ncotti/pcbs/cotti_probe/image-1.png

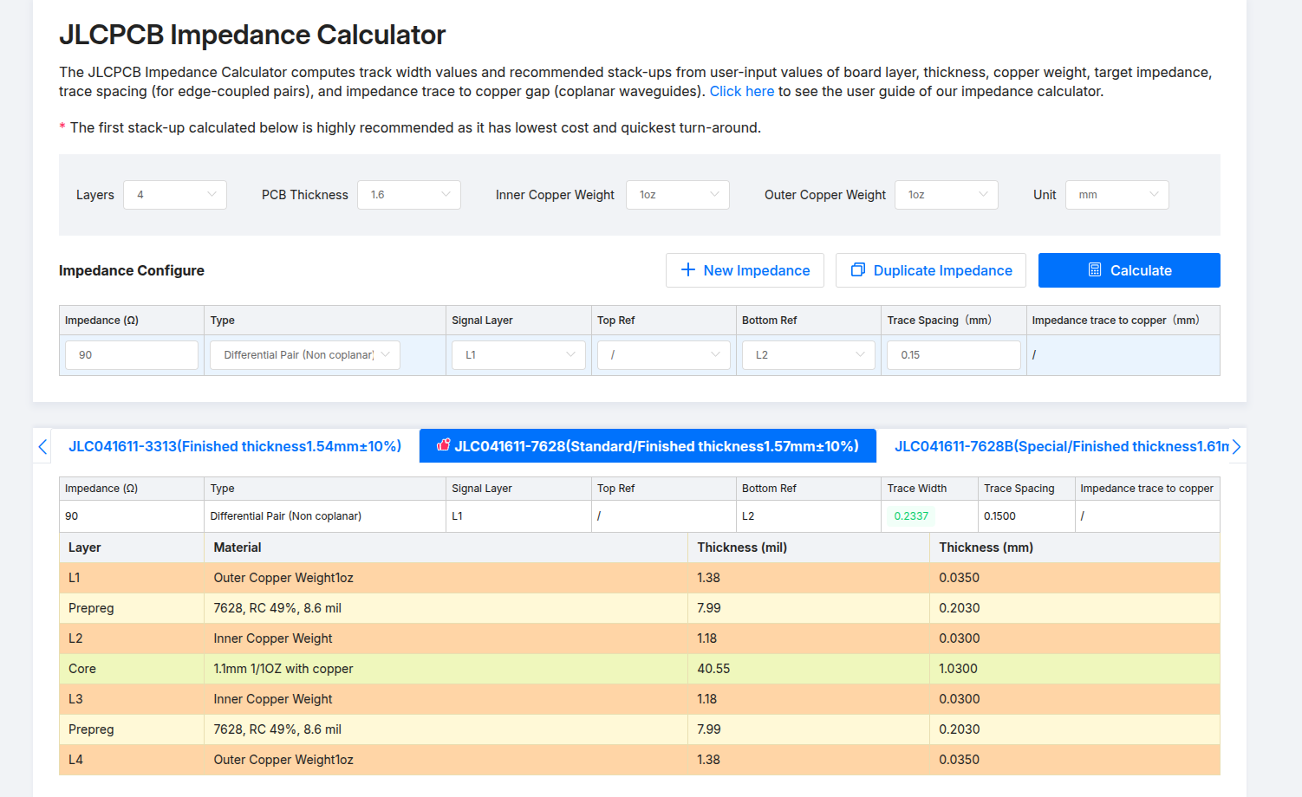
cotti_probe/image-1.png
