ncotti/pcbs/cotti_probe/image.png

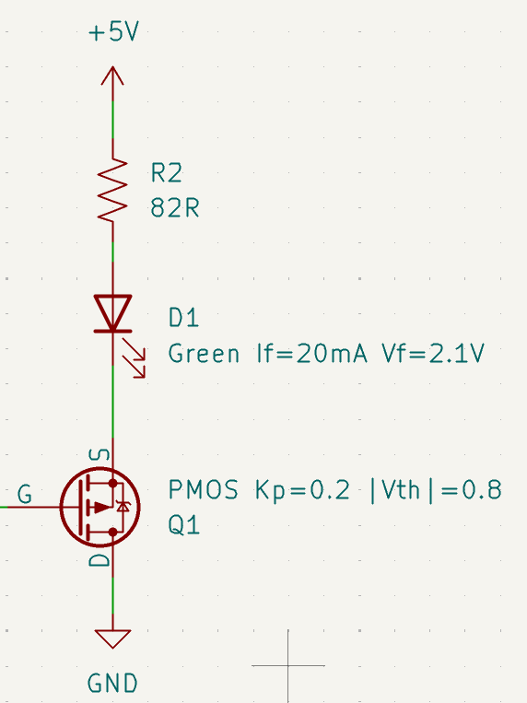
cotti_probe/image.png
