ncotti/pcbs/cotti_probe/3d_models/ABLS-12.000MHZ-20-B4Y-T.stp

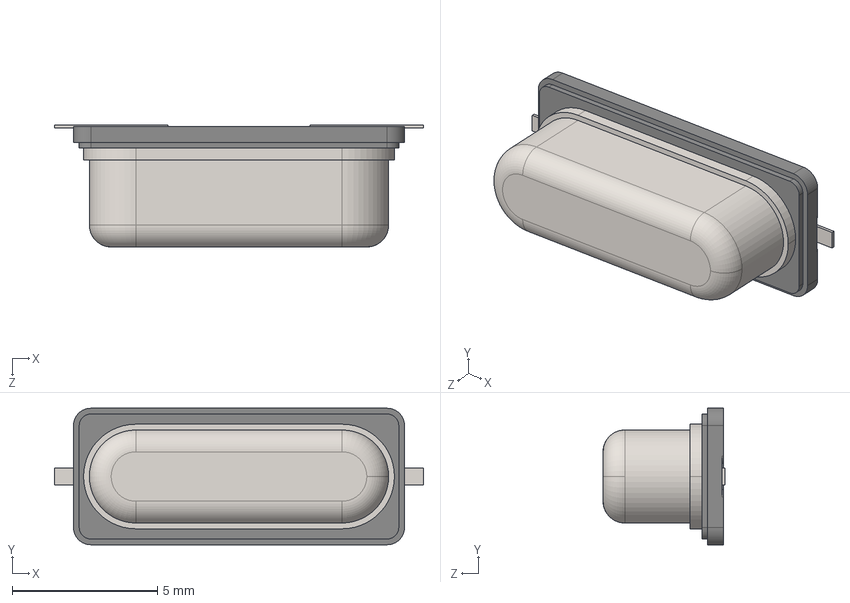
[picture p10: CAD file, 2025-12-12]
cotti_probe/3d_models/ABLS-12.000MHZ-20-B4Y-T.stp
12.7 x 4.70 x 4.20 mm
