ncotti/pcbs/microprocessors/nuvoton_nuc980/docs/reference_designs/NK-980IOT.pdf

# nRESET VDD12 VDD33 VSS

# PG5 PF[12:11]

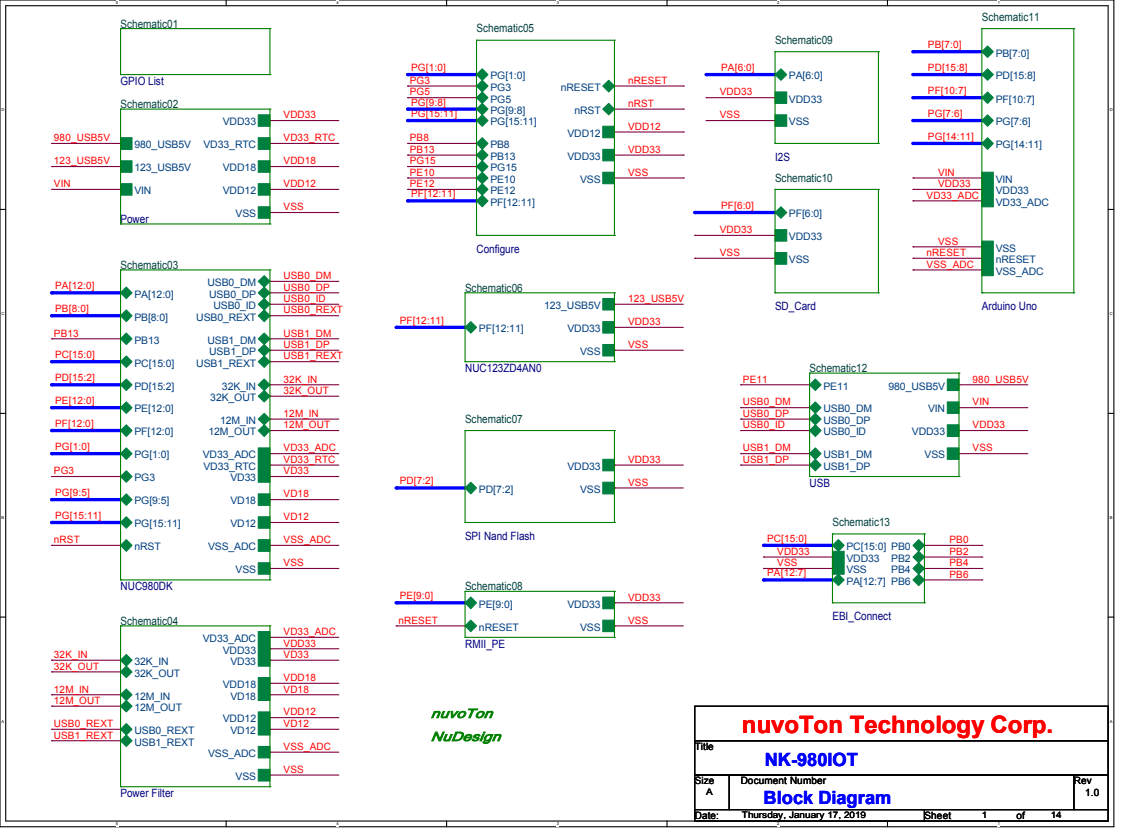
[picture p11: page 1]
A A nuvoTon; NuDesign; 123_USB5V; 980_USB5V; VDD12 VSS; VDD18 VDD33 VD33_RTC; VIN; VD12 VD18 VD33 VD33_ADC; VD33_RTC; VSS_ADC; VSS; 32K_IN 32K_OUT; 12M_IN 12M_OUT; USB0_DP; USB0_DM; USB0_REXT; USB0_ID; USB1_DP; USB1_DM; USB1_REXT; VDD12 VDD33 VSS_ADC; 32K_OUT; 12M_OUT; VDD18 VD12 VD18 VD33 VD33_ADC; VDD33 VSS; VDD33 PD[7:2]; nRESET PE[9:0]; VDD33 VSS USB0_DP; USB0_REXT USB1_REXT; nRST; VDD33 PA[6:0] VSS; VDD33 PF[6:0]; nRESET VSS; VDD33 VD33_ADC; PB0 PB2 PB4 PB6 Title Size; Document Number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

PF[10:7] nRESET VDD33 VSS

nuvoTon Technology Corp. A
NK-980IOT

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
## PIN

PA7

PA6

PA2

PA9

PA1

## FUNCTION

PA0

PA5

PA3

## I2C0_SDA

## USB0_VBUSVLD

## FUNCTION

PF4

## PIN

PF1

## JTAG0_TDO SPI1_SS0 PWM10

## JTAG0_TMS SPI1_DO PWM12 UART5_RXD

PF2

PF3

## JTAG0_NTRST LED_G

## JTAG0_TDI SPI1_DI PWM13 UART5_TXD

## JTAG0_TCK SPI1_CLK PWM11

PF0

## RMII0_TXD0

## RMII0_RXERR

PE10

PE8

PE6

## RMII0_REFCLK

## RMII0_TXD1

PE3

PE7

## RMII0_MDC

PE4

PE0

## RMII0_MDIO

## RMII0_RXD1

## FUNCTION

PE5

PE9

## RMII0_CRSDV

## RMII0_RXD0

## RMII0_TXEN

PE1

PE2

## PIN

PG1 | CFG[1]
PIN | FUNCTION

PG9

PG8

PG0

PG5

PG3

PA10

PA11

PA12

## LED_Y

## I2S_BCLK

## I2S_DI

## EBI_nRE

## EBI_nCS0

## EBI_ADDR9 (LCD_RESET) EBI_ADDR8 (LCD_BL)

PC13

PC15

PC14

PC8

PC11

PC3

PC1

## PIN

PC4

PC5

PC6

PC9

PC12

## FUNCTION

PC10

PC2

PC7

## CFG[5]

PG6

PG7

PC0

PD7

## SPI0_SS0

## SPI0_CLK

## FUNCTION

PD8

PD9

PD6

PD5

PD4

PD2

PD3

## PIN

PD10

## SPI0_DI UART6_RXD

## SPI0_DO UART6_TXD

PD11

PD12

PD13

PD14

PD15

PG11

PG12

PG13

PG14

PG15

PF5

PF6

PF7

PF8

PF9

PF10

PF11

PF12

## UART0_RXD

## UART0_TXD

PE11

PE12

## ADC_AIN[0]

PB5

PB4

## I2C2_SCL ADC_AIN[5]

PB1

PB6

## I2C2_SDA ADC_AIN[7]

PB8

## I2C1_SCL ADC_AIN[4] UART7_RXD

PB3

PB13

PB0

PB7

## PIN

PB2

## FUNCTION

## I2C1_SDA ADC_AIN[6] UART7_TXD

## I2S_DO

## EBI_ADDR10 (LCD_RS)

## I2C0_SCL

## UART4_TXD PWM00

## QSPI0_SS0

## I2S_MCLK

## EBI_nWE

## Key1

## Key2

## CFG[0]

## CFG[3]

## CFG[8]

## CFG[9]

## I2S_LRCK

## ADC_AIN[1] UART9_TXD

## ADC_AIN[3] UART9_RXD

## ADC_AIN[2]

## EBI_DATA0

## EBI_DATA1

## EBI_DATA2

## EBI_DATA3

## EBI_DATA4

## EBI_DATA5

## EBI_DATA6

## EBI_DATA7

## EBI_DATA8

## EBI_DATA9

## EBI_DATA10

## EBI_DATA11

## EBI_DATA12

## EBI_DATA13

## EBI_DATA14

## EBI_DATA15

## QSPI0_CLK

## QSPI0_DO

## QSPI0_DI

## QSPI0_D2

## QSPI0_D3

## UART4_RXD PWM01

## I2C3_SCL PWM02 I2C3_SDA PWM03

## SD1_CMD eMMC1_CMD SD1_CLK eMMC1_CLK SD1_DATA0 eMMC1_DATA0 SD1_DATA1 eMMC1_DATA1 SD1_DATA2 eMMC1_DATA2 SD1_DATA3 eMMC1_DATA3

## SD1_nCD

## PWM02

## PWM03 UART1_RXD PWM10

## LED_R

## UART1_TXD PWM11

## UART5_RXD PWM10 UART5_TXD PWM11

Title Size | Document Number | Rev Date: | Sheet | of
GPIO List | 1.0

# NK-980IOT

# nuvoTon Technology Corp. A

Thursday, January 17, 2019 | 2 | 14 Title Size | Document Number | Rev Date: | Sheet | of
GPIO List | 1.0

# NK-980IOT

# nuvoTon Technology Corp. A

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

# NK-980IOT

# nuvoTon Technology Corp. A

Thursday, January 17, 2019 | 2 | 14

### P_Fault

### 5V IN

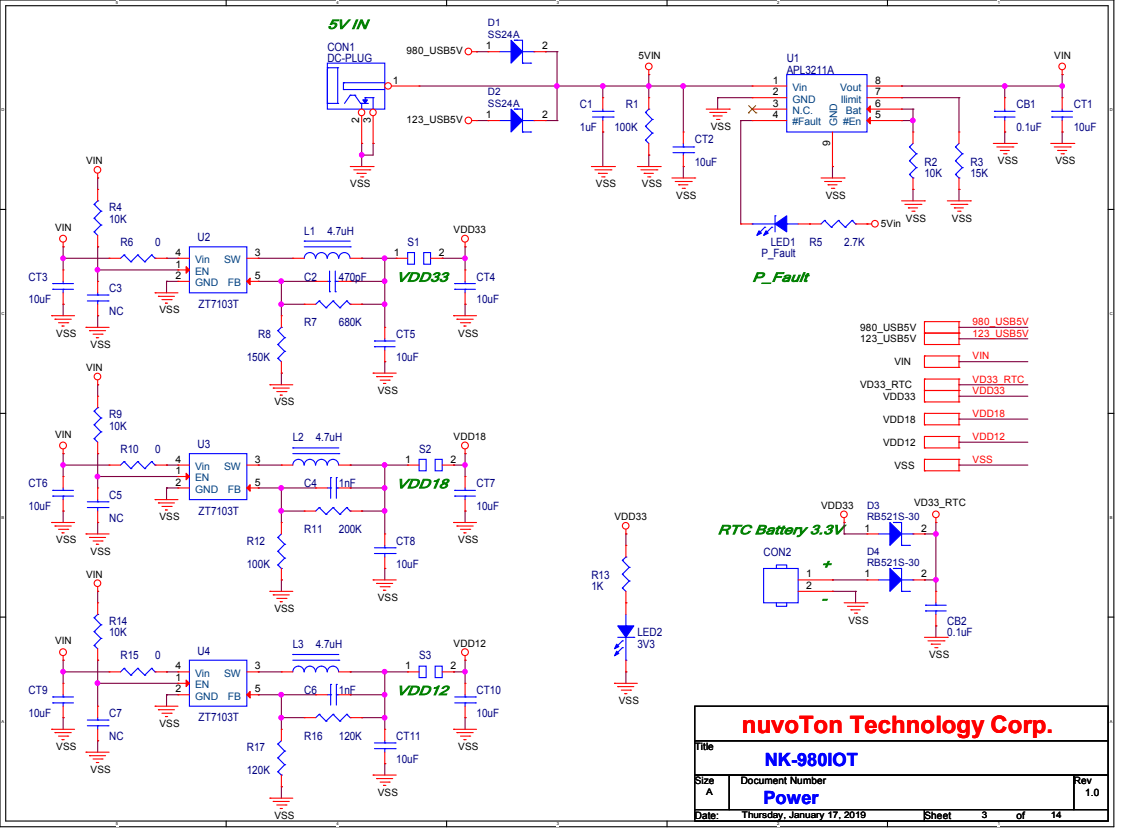
[picture p12: page 3]

PA[12:0] PB[8:0] PB13 PC[15:0] PD[15:2] PE[12:0] PF[12:0] PG[1:0] PG3 PG[9:5] PG[15:11] VD12 VD18 VD33 VD33_ADC

# PB7 PC0 PC1 PC2 PC3 PC4 PC5 PC6 VD33_RTC

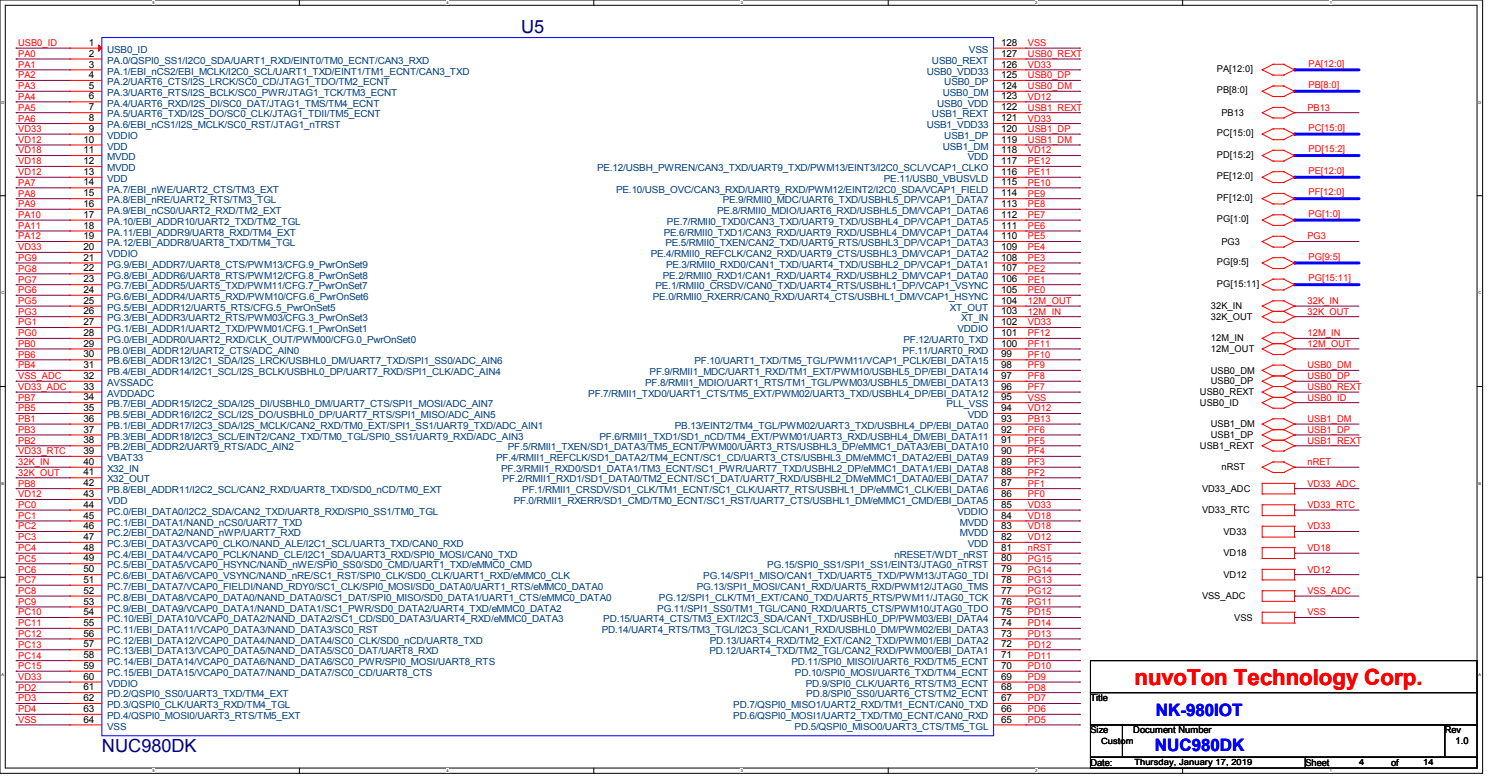
[picture p13: page 4]
VD33_RTC; VSS_ADC; VSS; nRET; 32K_IN 32K_OUT; 12M_IN 12M_OUT USB0_DP USB0_DM; USB0_REXT USB0_ID; USB1_DP USB1_DM; USB1_REXT PD2 PD3 PD4; VD33_ADC; PA0 USB0_ID; nRST PF0 PF4 PF3 PF2 PF5 PD5; PF6 PF1 PB13 PD8 PD7 PD9 PD6 PD14 PD10 PD13 PD12 PD11 PG13 PG12 PG11 PD15 PG14 PG15 VD33 VD18 VD12 VSS; 12M_OUT VD12 PF8 PF10 PF11 PF12 PE1 PE3 PE0 PE4 PE5 PE2 PE6 PE7 PE9 PE10 PE11 PE8 VD33 PF9; VD12 VD33 VD33 USB0_DP USB0_DM; USB0_REXT USB1_REXT VSS; nRST; 12M_IN 12M_OUT USB0_DM; USB0_DP USB0_REXT USB0_ID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

USB0_ID 1 PA.0/QSPI0_SS1/I2C0_SDA/UART1_RXD/EINT0/TM0_ECNT/CAN3_RXD 2 PA.1/EBI_nCS2/EBI_MCLK/I2C0_SCL/UART1_TXD/EINT1/TM1_ECNT/CAN3_TXD 3 PA.2/UART6_CTS/I2S_LRCK/SC0_CD/JTAG1_TDO/TM2_ECNT 4 PA.3/UART6_RTS/I2S_BCLK/SC0_PWR/JTAG1_TCK/TM3_ECNT 5 PA.4/UART6_RXD/I2S_DI/SC0_DAT/JTAG1_TMS/TM4_ECNT 6 PA.5/UART6_TXD/I2S_DO/SC0_CLK/JTAG1_TDII/TM5_ECNT 7 PA.6/EBI_nCS1/I2S_MCLK/SC0_RST/JTAG1_nTRST 8 VDDIO 9 VDD
PA1 PA2 PA3 PA4 PA5 PA6 PA7 PA8 PA9 PA10 VD12 VD18 VD18 VD33 VD12 PG3 PB4 PA11 PA12 PG0 PG5 PG1 PG6 PG7 PG8 PG9 PB0 PB6 VD33 VSS_ADC

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

118 PE.12/USBH_PWREN/CAN3_TXD/UART9_TXD/PWM13/EINT3/I2C0_SCL/VCAP1_CLKO 117 PE.11/USB0_VBUSVLD 116 PE.9/RMII0_MDC/UART6_TXD/USBHL5_DP/VCAP1_DATA7 114 PE.8/RMII0_MDIO/UART6_RXD/USBHL5_DM/VCAP1_DATA6 113 PE.7/RMII0_TXD0/CAN3_TXD/UART9_TXD/USBHL4_DP/VCAP1_DATA5 112 PE.6/RMII0_TXD1/CAN3_RXD/UART9_RXD/USBHL4_DM/VCAP1_DATA4 111 PE.5/RMII0_TXEN/CAN2_TXD/UART9_RTS/USBHL3_DP/VCAP1_DATA3 110 PE.4/RMII0_REFCLK/CAN2_RXD/UART9_CTS/USBHL3_DM/VCAP1_DATA2 109 PE.3/RMII0_RXD0/CAN1_TXD/UART4_TXD/USBHL2_DP/VCAP1_DATA1 108 PE.2/RMII0_RXD1/CAN1_RXD/UART4_RXD/USBHL2_DM/VCAP1_DATA0 107 PE.1/RMII0_CRSDV/CAN0_TXD/UART4_RTS/USBHL1_DP/VCAP1_VSYNC 106 PE.0/RMII0_RXERR/CAN0_RXD/UART4_CTS/USBHL1_DM/VCAP1_HSYNC 105 XT_OUT 104 XT_IN

103 VDDIO 102 PF.12/UART0_TXD 101 PF.11/UART0_RXD 100 PF.10/UART1_TXD/TM5_TGL/PWM11/VCAP1_PCLK/EBI_DATA15 99 PF.9/RMII1_MDC/UART1_RXD/TM1_EXT/PWM10/USBHL5_DP/EBI_DATA14 98 PF.8/RMII1_MDIO/UART1_RTS/TM1_TGL/PWM03/USBHL5_DM/EBI_DATA13 97 PE.10/USB_OVC/CAN3_RXD/UART9_RXD/PWM12/EINT2/I2C0_SDA/VCAP1_FIELD 115

AVDDADC 33 PB.7/EBI_ADDR15/I2C2_SDA/I2S_DI/USBHL0_DM/UART7_CTS/SPI1_MOSI/ADC_AIN7 34 PB.5/EBI_ADDR16/I2C2_SCL/I2S_DO/USBHL0_DP/UART7_RTS/SPI1_MISO/ADC_AIN5 35 PB.1/EBI_ADDR17/I2C3_SDA/I2S_MCLK/CAN2_RXD/TM0_EXT/SPI1_SS1/UART9_TXD/ADC_AIN1 36 PB.3/EBI_ADDR18/I2C3_SCL/EINT2/CAN2_TXD/TM0_TGL/SPI0_SS1/UART9_RXD/ADC_AIN3 37 PB.2/EBI_ADDR2/UART9_RTS/ADC_AIN2 38 VBAT33 39 X32_IN 40 X32_OUT 41 PB.8/EBI_ADDR11/I2C2_SCL/CAN2_RXD/UART8_TXD/SD0_nCD/TM0_EXT 42 VDD 43 PC.0/EBI_DATA0/I2C2_SDA/CAN2_TXD/UART8_RXD/SPI0_SS1/TM0_TGL 44 PC.1/EBI_DATA1/NAND_nCS0/UART7_TXD 45 PC.2/EBI_DATA2/NAND_nWP/UART7_RXD 46 PC.3/EBI_DATA3/VCAP0_CLKO/NAND_ALE/I2C1_SCL/UART3_TXD/CAN0_RXD 47 PC.4/EBI_DATA4/VCAP0_PCLK/NAND_CLE/I2C1_SDA/UART3_RXD/SPI0_MOSI/CAN0_TXD 48 PC.5/EBI_DATA5/VCAP0_HSYNC/NAND_nWE/SPI0_SS0/SD0_CMD/UART1_TXD/eMMC0_CMD 49 PC.6/EBI_DATA6/VCAP0_VSYNC/NAND_nRE/SC1_RST/SPI0_CLK/SD0_CLK/UART1_RXD/eMMC0_CLK 50 PC.7/EBI_DATA7/VCAP0_FIELDI/NAND_RDY0/SC1_CLK/SPI0_MOSI/SD0_DATA0/UART1_RTS/eMMC0_DATA0 51 PC.8/EBI_DATA8/VCAP0_DATA0/NAND_DATA0/SC1_DAT/SPI0_MISO/SD0_DATA1/UART1_CTS/eMMC0_DATA0 52 PC.9/EBI_DATA9/VCAP0_DATA1/NAND_DATA1/SC1_PWR/SD0_DATA2/UART4_TXD/eMMC0_DATA2 53 PC.10/EBI_DATA10/VCAP0_DATA2/NAND_DATA2/SC1_CD/SD0_DATA3/UART4_RXD/eMMC0_DATA3 54 PC.11/EBI_DATA11/VCAP0_DATA3/NAND_DATA3/SC0_RST 55 PC.12/EBI_DATA12/VCAP0_DATA4/NAND_DATA4/SC0_CLK/SD0_nCD/UART8_TXD 56 PC.13/EBI_DATA13/VCAP0_DATA5/NAND_DATA5/SC0_DAT/UART8_RXD 57 PC.14/EBI_DATA14/VCAP0_DATA6/NAND_DATA6/SC0_PWR/SPI0_MOSI/UART8_RTS 58 PC.15/EBI_DATA15/VCAP0_DATA7/NAND_DATA7/SC0_CD/UART8_CTS 59 VDDIO 60 PD.2/QSPI0_SS0/UART3_TXD/TM4_EXT 61 PD.3/QSPI0_CLK/UART3_RXD/TM4_TGL 62 PD.4/QSPI0_MOSI0/UART3_RTS/TM5_EXT 63 VSS 64
32K_OUT VD12 PB1 PB2 PB3 PB5 VSS

94 PB.13/EINT2/TM4_TGL/PWM02/UART3_TXD/USBHL4_DP/EBI_DATA0 93 PF.6/RMII1_TXD1/SD1_nCD/TM4_EXT/PWM01/UART3_RXD/USBHL4_DM/EBI_DATA11 92 PF.5/RMII1_TXEN/SD1_DATA3/TM5_ECNT/PWM00/UART3_RTS/USBHL3_DP/eMMC1_DATA3/EBI_DATA10 91 PF.4/RMII1_REFCLK/SD1_DATA2/TM4_ECNT/SC1_CD/UART3_CTS/USBHL3_DM/eMMC1_DATA2/EBI_DATA9 90 PF.3/RMII1_RXD0/SD1_DATA1/TM3_ECNT/SC1_PWR/UART7_TXD/USBHL2_DP/eMMC1_DATA1/EBI_DATA8 89 PF.2/RMII1_RXD1/SD1_DATA0/TM2_ECNT/SC1_DAT/UART7_RXD/USBHL2_DM/eMMC1_DATA0/EBI_DATA7 88 PF.1/RMII1_CRSDV/SD1_CLK/TM1_ECNT/SC1_CLK/UART7_RTS/USBHL1_DP/eMMC1_CLK/EBI_DATA6 87 PF.0/RMII1_RXERR/SD1_CMD/TM0_ECNT/SC1_RST/UART7_CTS/USBHL1_DM/eMMC1_CMD/EBI_DATA5 86 VDDIO 85 MVDD

nuvoTon Technology Corp. Custom
NK-980IOT

# VDD12 VDD33 VSS_ADC

# 12M_OUT VDD18 VD12 VD18 VD33 VD33_ADC

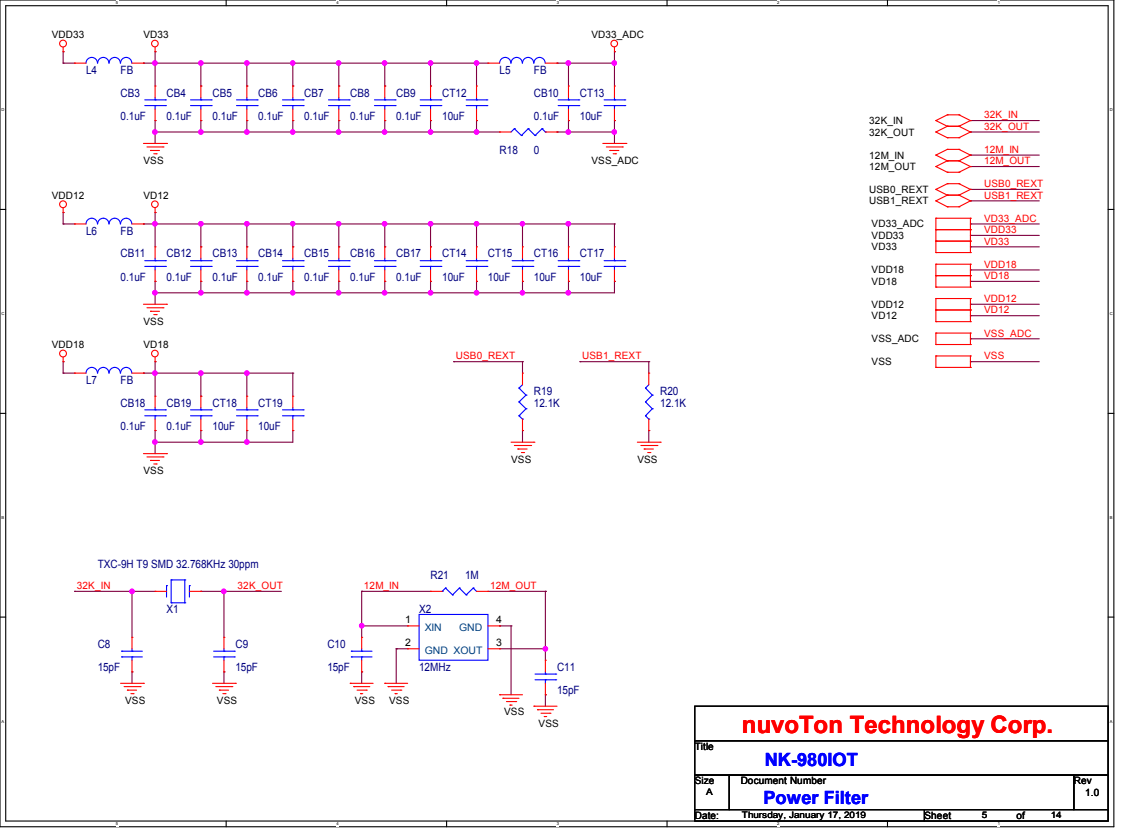
[picture p14: page 5]

LED3 | LED4

### Power On Setting

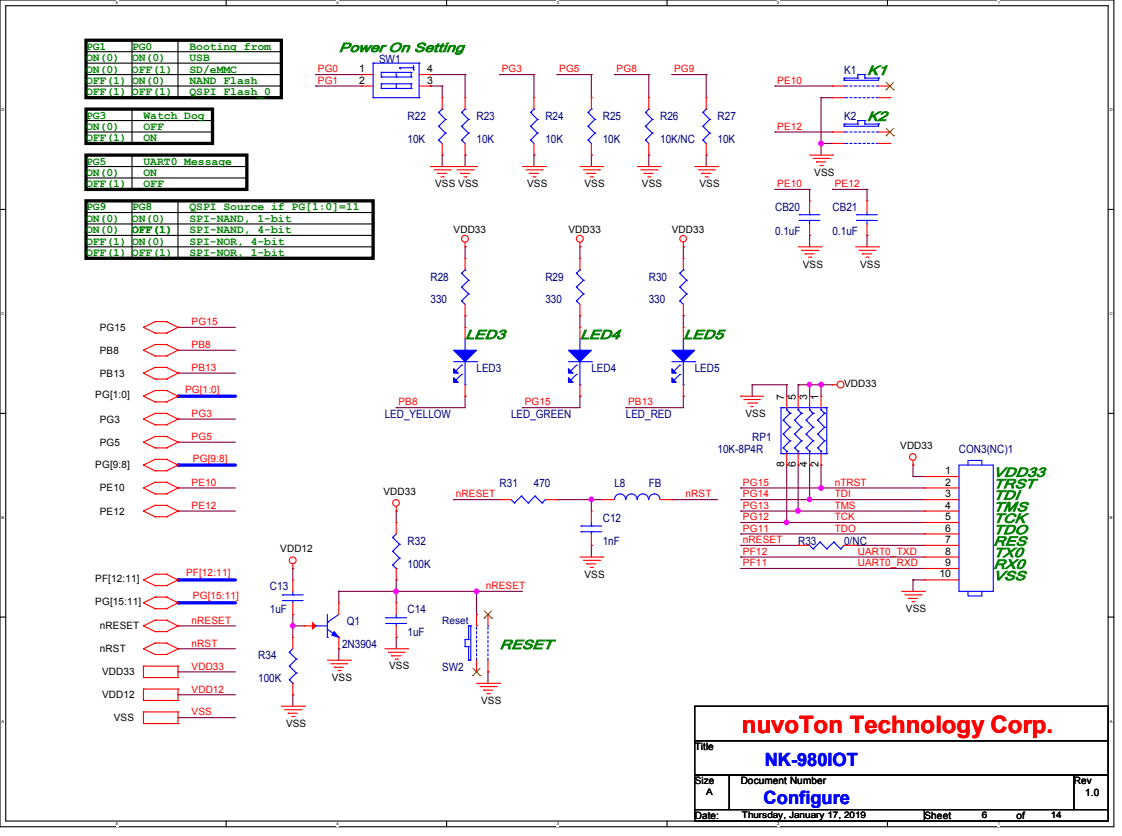
[picture p15: page 6]

VDD33 TRST TDI TMS TCK TDO RES

# VDD33 VDD33

# VDD33 VSS

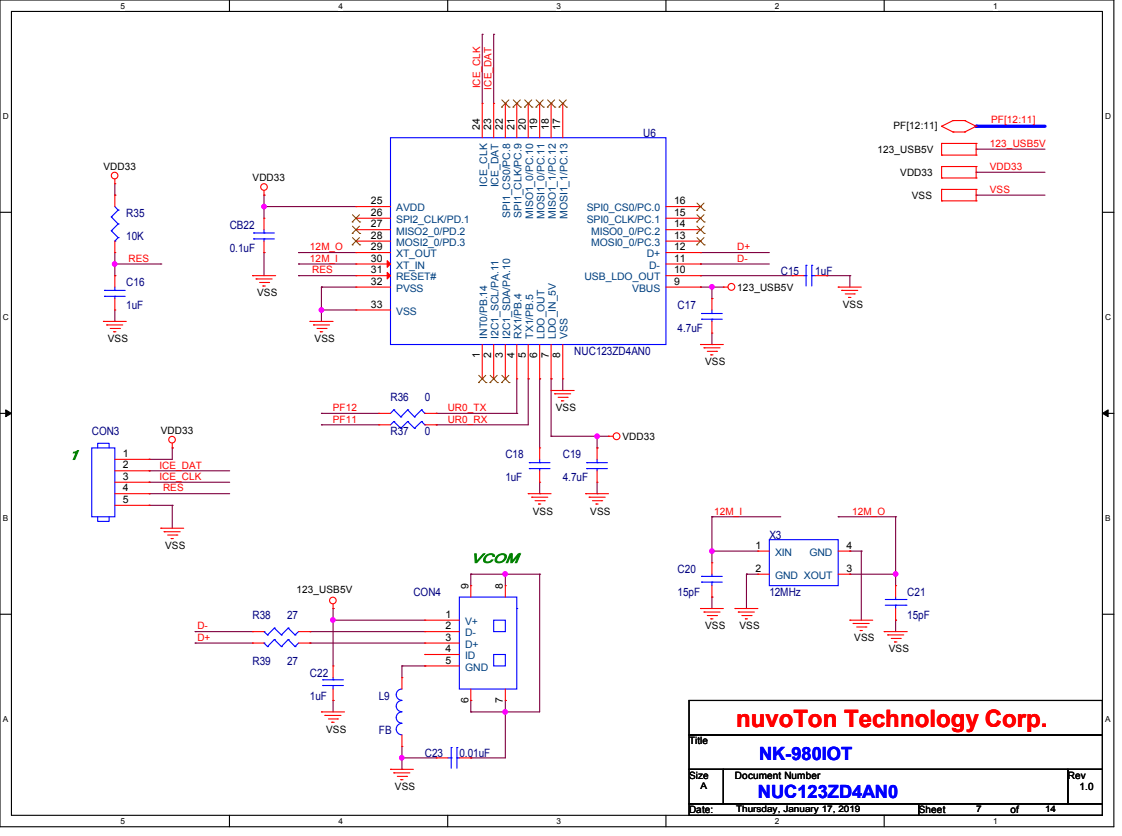
[picture p16: page 7]

1 RESET# 31 XT_IN 30 XT_OUT 29 AVDD 25 PVSS 32 MOSI1_1/PC.13 17 MISO1_1/PC.12 18 MOSI1_0/PC.11 19 MISO1_0/PC.10 20 SPI1_CLK/PC.9 21 SPI1_CS0/PC.8 22 ICE_CLK 24 ICE_DAT 23 VSS 33 C21

### QSPI0_Flash VDD33 VSS

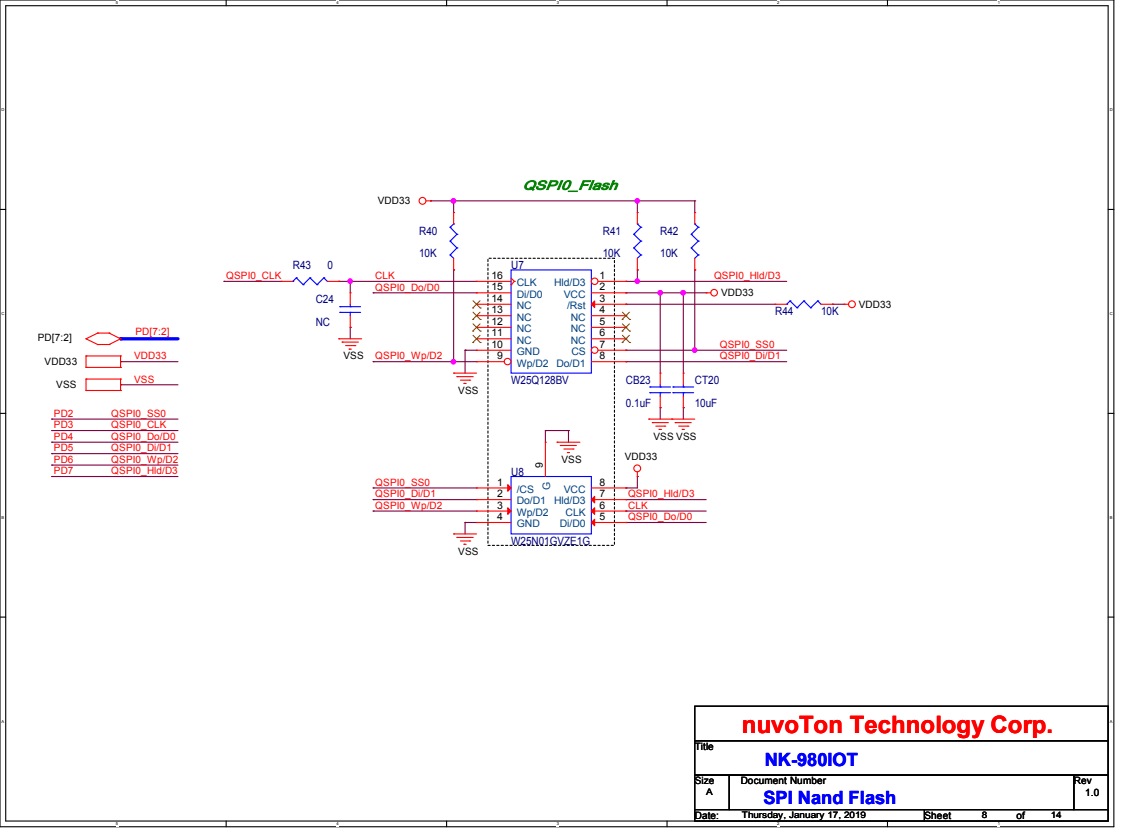
[picture p17: page 8]

# PE[9:0] VDD33 VSS

# PE[9:0] VDD33 VSS

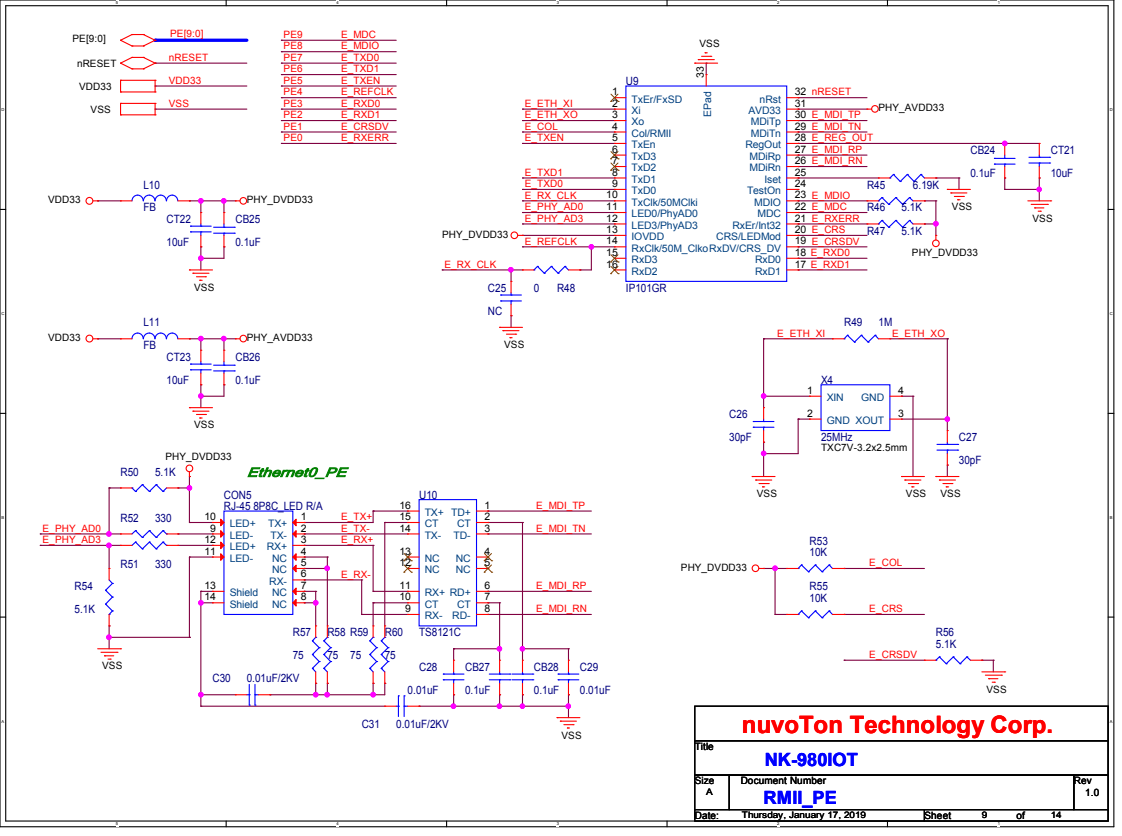
[picture p18: page 9]

TxEr/FxSD 1 Xi 2 Xo 3 Col/RMII 4 TxEn 5 TxD3 6 TxD2 7 TxD1 8 TxD0 9 TxClk/50MClki 10

nRst 32 AVD33 31 MDiTp 30 MDiTn 29 RegOut 28 MDiRp 27 MDiRn 26

Microphone | Speaker

### Earphone

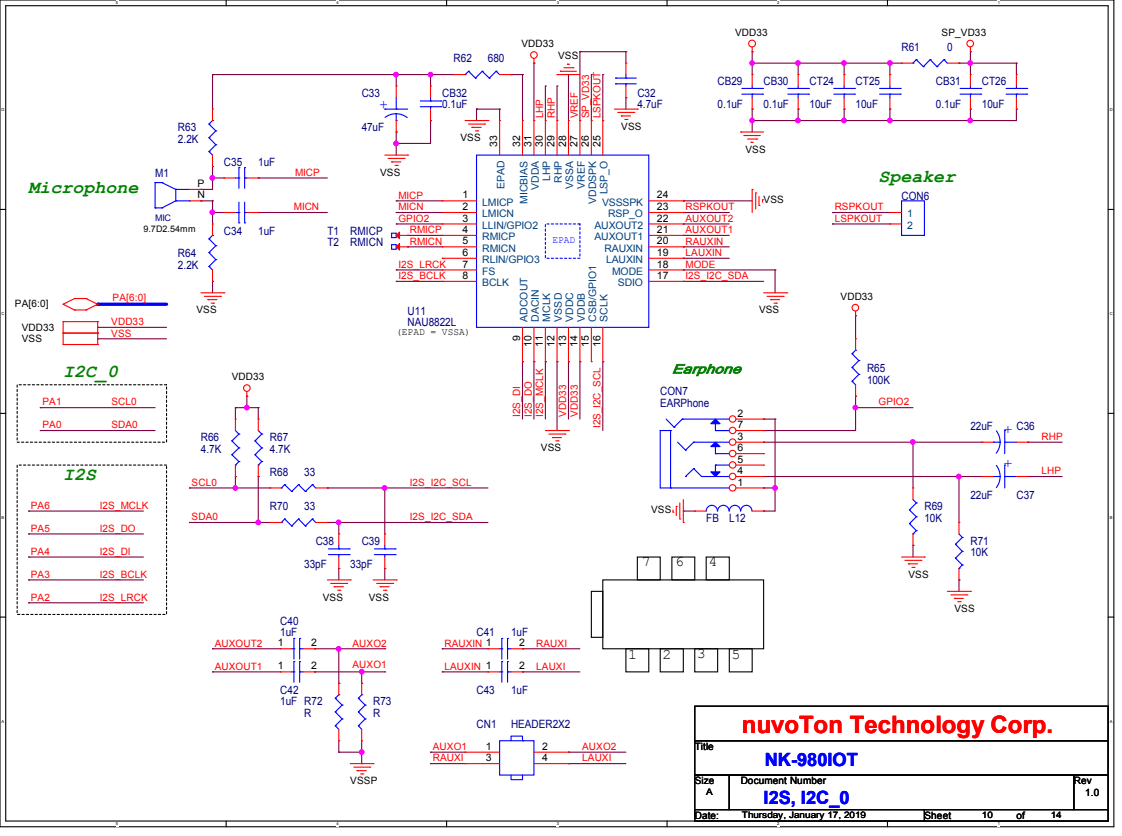
[picture p19: page 10]

9 DACIN 10 MCLK 11 VSSD 12 VDDC 13 VDDB 14 CSB/GPIO1 15 SCLK 16 SDIO MODE 17

### SD1/eMMC1

# VDD33 VSS

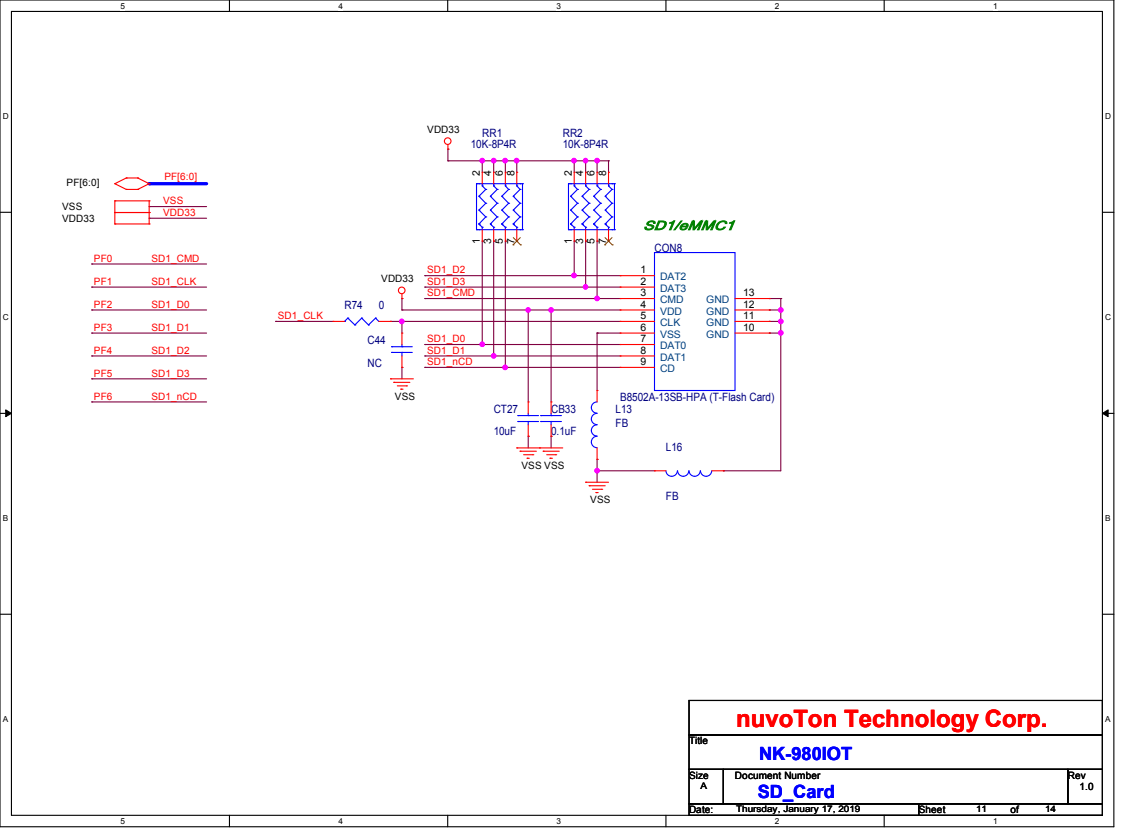
[picture p20: page 11]
SD1_CMD; SD1_CLK; SD1_nCD; PF[6:0] VSS; VDD33; SD1_D3 SD1_CMD; VSS VSS; VSS; Title Size; Document Number; Rev Date:; Sheet; SD_Card; Thursday, January 17, 2019; 14 Title Size; CON8; B8502A-13SB-HPA (T-Flash Card) DAT2 1 DAT3 2 CMD 3 VDD 4 CLK 5 VSS 6 DAT0 7 DAT1 8 CD 9; GND 10 GND 11 GND 12 GND 13

nuvoTon Technology Corp. A
NK-980IOT

### RESET VDD33

### VDD33

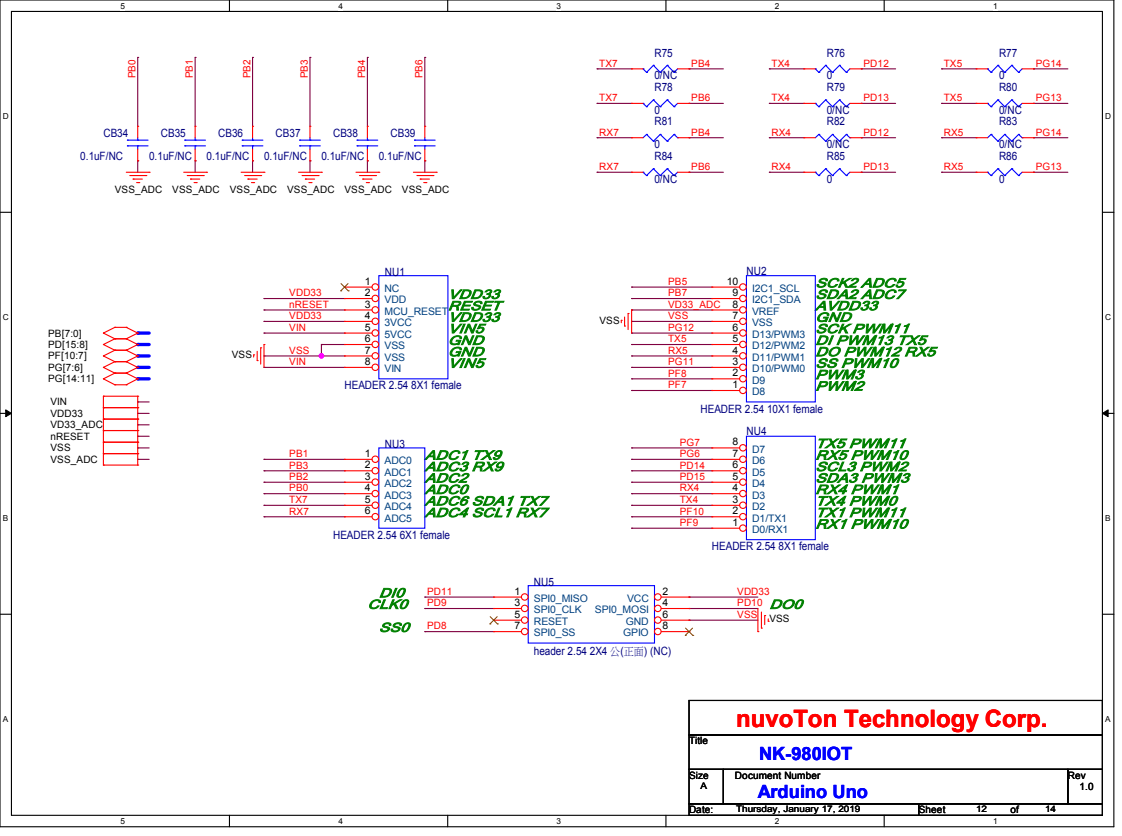
[picture p21: page 12]

HEADER 2.54 8X1 female NC 1 VDD 2 MCU_RESET 3

### USB0 HOST

### USB0 Device/HOST

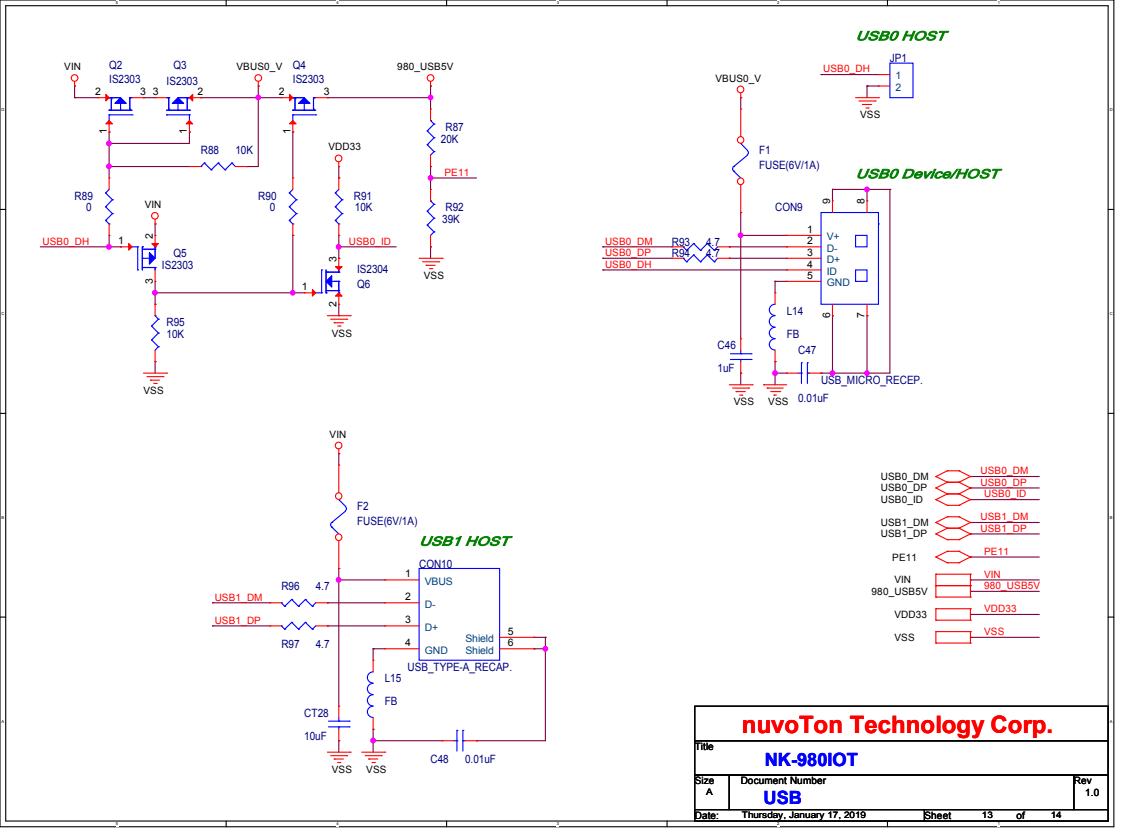
[picture p22: page 13]

# PA[12:7] PB2 PB0 PB4 PB6

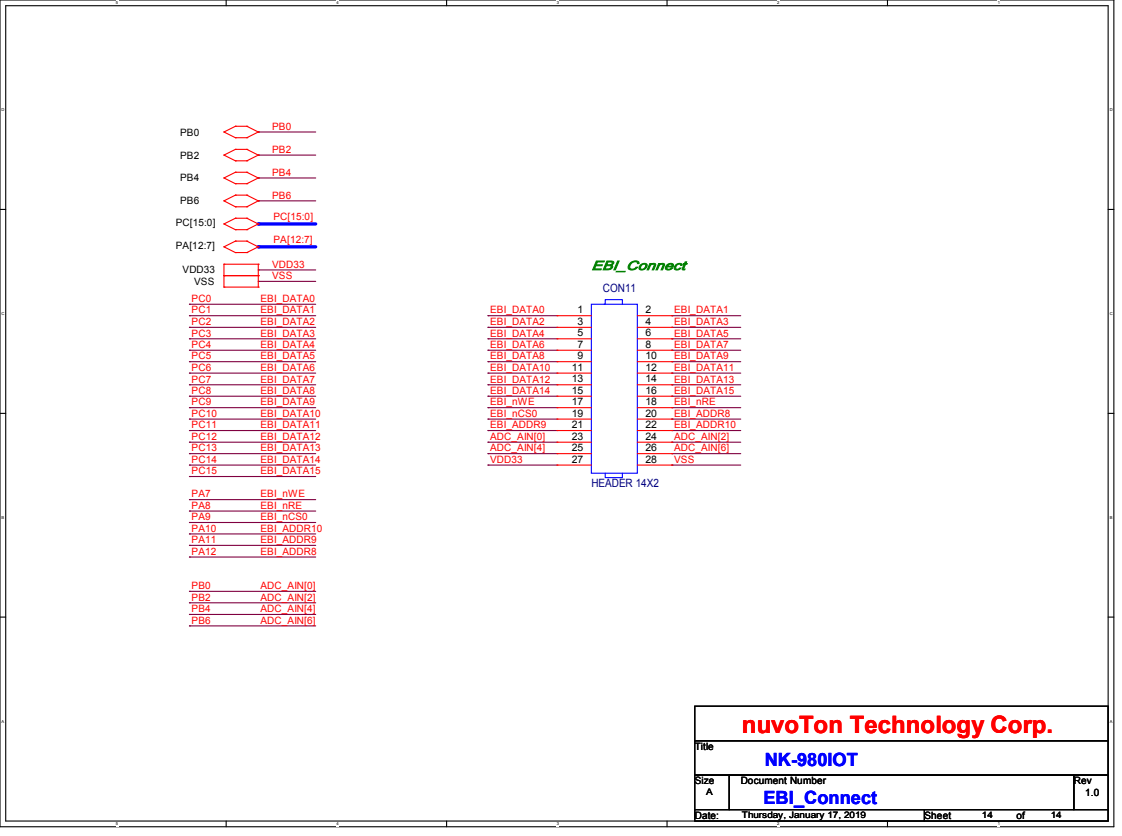
[picture p23: page 14]
EBI_Connect PC7; EBI_DATA7 PC5; EBI_DATA5 PC4; EBI_DATA4 PC6; EBI_DATA6 PC3; EBI_DATA3 PC1; EBI_DATA1 PC2; EBI_DATA2 PC0; EBI_DATA0 PC11; EBI_DATA11 PC10; EBI_DATA10 PC13; EBI_DATA13 PC12; EBI_DATA12 PC14; EBI_DATA14 PC15; EBI_DATA15; EBI_DATA8; EBI_DATA4 EBI_DATA6; EBI_DATA2; EBI_DATA0; EBI_DATA10; EBI_DATA3; EBI_DATA7; EBI_DATA1; EBI_DATA5; EBI_DATA12; EBI_DATA13; EBI_DATA14; EBI_nCS0; EBI_nWE; EBI_ADDR9; EBI_ADDR10 VDD33 VSS; EBI_DATA9 EBI_DATA11; EBI_nRE; EBI_ADDR8 PC8; EBI_DATA8 PC9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

nuvoTon Technology Corp. A
NK-980IOT
