ncotti/pcbs/(commit log)

2025-12-12 feat: first commit
    [ABLS-12.000MHZ-20-B4Y-T.stp, connectors_sch.kicad_sch, cotti_leds.kicad_pcb, cotti_leds.kicad_sch, cotti_probe.csv, cotti_probe.kicad_pcb, cotti_probe.kicad_sch]
2025-12-15 feat: cotti_leds schematic
    [MS4208L4.stp, cotti_leds.kicad_sch, led_frontend.kicad_sch]
2025-12-17 feat: cotti_leds first version
    [cotti_leds.kicad_pcb, cotti_leds.kicad_sch, led_frontend.kicad_sch]
2025-12-18 feat: cotti_leds v0.0
    [cotti_leds.kicad_pcb]
2025-12-20 feat: cotti buttons module
    [button.kicad_sch, cotti_buttons.kicad_pcb, cotti_buttons.kicad_sch]
2025-12-21 feat: 7seg
    [cotti_7seg.kicad_pcb, cotti_7seg.kicad_sch, led_driver.kicad_sch, nmos_array.kicad_sch, nmos_arry.kicad_sch]
2025-12-26 feat: level shifter
    [cotti_level_shifter.kicad_pcb, cotti_level_shifter.kicad_sch, level_shifter.kicad_sch]
2025-12-27 feat: soldering practice first commit
    [soldering_practice.kicad_pcb, soldering_practice.kicad_sch]
2025-12-27 docs: add chatgpt answer about footprint sizes
2026-01-13 feat: nuvoton passing schematic DRC
    [boot.kicad_sch, connectors.kicad_sch, ethernet.kicad_sch, nand_flash.kicad_sch, nuvoton_nuc980.kicad_pcb, nuvoton_nuc980.kicad_sch, power.kicad_sch, reset_and_xtals.kicad_sch]
2026-01-17 feat: cotti leds with new library format
    [cotti_leds.kicad_pcb, cotti_leds.kicad_sch, led_frontend.kicad_sch, nuvoton_nuc980.kicad_sch, usb.kicad_sch]
2026-01-17 feat: cotti uttons with new libs
    [button.kicad_sch, cotti_buttons.kicad_pcb, cotti_buttons.kicad_sch]
2026-01-17 feat: cotti leds gerber files
    [cotti_leds-B_Cu.gbr, cotti_leds-B_Mask.gbr, cotti_leds-B_Paste.gbr, cotti_leds-B_Silkscreen.gbr, cotti_leds-Edge_Cuts.gbr, cotti_leds-F_Cu.gbr, cotti_leds-F_Mask.gbr, cotti_leds-F_Paste.gbr]
2026-01-17 feat: cotti buttons gerber files
    [button.kicad_sch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]
2026-01-17 feat: level shifter gerbers
    [cotti_level_shifter-B_Cu.gbr, cotti_level_shifter-B_Mask.gbr, cotti_level_shifter-B_Paste.gbr, cotti_level_shifter-B_Silkscreen.gbr, cotti_level_shifter-Edge_Cuts.gbr, cotti_level_shifter-F_Cu.gbr, cotti_level_shifter-F_Mask.gbr, cotti_level_shifter-F_Paste.gbr]
2026-01-18 feat: cotti 7seg gerbers
    [cotti_7seg-B_Cu.gbr, cotti_7seg-B_Mask.gbr, cotti_7seg-B_Paste.gbr, cotti_7seg-B_Silkscreen.gbr, cotti_7seg-Edge_Cuts.gbr, cotti_7seg-F_Cu.gbr, cotti_7seg-F_Mask.gbr, cotti_7seg-F_Paste.gbr]
2026-01-18 fix: remove soldering practice board
    [soldering_practice.kicad_pcb, soldering_practice.kicad_sch]
2026-01-18 fix: missing descriptions in footprints and 3d model for 7seg
    [cotti_7seg.kicad_pcb]
2026-01-18 fix: change "vcc" to "3v3" power input
    [cotti_7seg-B_Cu.gbr, cotti_7seg-B_Mask.gbr, cotti_7seg-B_Paste.gbr, cotti_7seg-B_Silkscreen.gbr, cotti_7seg-Edge_Cuts.gbr, cotti_7seg-F_Cu.gbr, cotti_7seg-F_Mask.gbr, cotti_7seg-F_Paste.gbr]
2026-01-18 feat: cotti temp sensor i2c
    [cotti_temp_humid_sensor-B_Cu.gbr, cotti_temp_humid_sensor-B_Mask.gbr, cotti_temp_humid_sensor-B_Paste.gbr, cotti_temp_humid_sensor-B_Silkscreen.gbr, cotti_temp_humid_sensor-Edge_Cuts.gbr, cotti_temp_humid_sensor-F_Cu.gbr, cotti_temp_humid_sensor-F_Mask.gbr, cotti_temp_humid_sensor-F_Paste.gbr]
2026-01-24 feat: gerbers for cotti probe
    [connectors_sch.kicad_sch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]
2026-01-24 fix: remove project libraries from cotti probe
2026-01-25 fix: length tune usb in probe
    [cotti_probe-B_Cu.gbr, cotti_probe-B_Mask.gbr, cotti_probe-B_Paste.gbr, cotti_probe-B_Silkscreen.gbr, cotti_probe-Edge_Cuts.gbr, cotti_probe-F_Cu.gbr, cotti_probe-F_Mask.gbr, cotti_probe-F_Paste.gbr]
2026-01-25 fix: usb track width in probe
    [cotti_probe-B_Cu.gbr, cotti_probe-B_Mask.gbr, cotti_probe-B_Paste.gbr, cotti_probe-B_Silkscreen.gbr, cotti_probe-Edge_Cuts.gbr, cotti_probe-F_Cu.gbr, cotti_probe-F_Mask.gbr, cotti_probe-F_Paste.gbr]
2026-01-31 feat: ERC passing cotti-nuvoton
    [boot.kicad_sch, connectors.kicad_sch, ethernet.kicad_sch, nand_flash.kicad_sch, nuvoton_nuc980.kicad_pcb, nuvoton_nuc980.kicad_sch, power.kicad_sch, sd_card.kicad_sch]
2026-02-01 feat: nuvoton gerber files
    [nuvoton_nuc980-B_Cu.gbr, nuvoton_nuc980-B_Mask.gbr, nuvoton_nuc980-B_Paste.gbr, nuvoton_nuc980-B_Silkscreen.gbr, nuvoton_nuc980-Edge_Cuts.gbr, nuvoton_nuc980-F_Cu.gbr, nuvoton_nuc980-F_Mask.gbr, nuvoton_nuc980-F_Paste.gbr]
